bigtreetech/MMB/Hardware/V2.0/BIGTREETECH MMB CAN V2.0-PIN.png

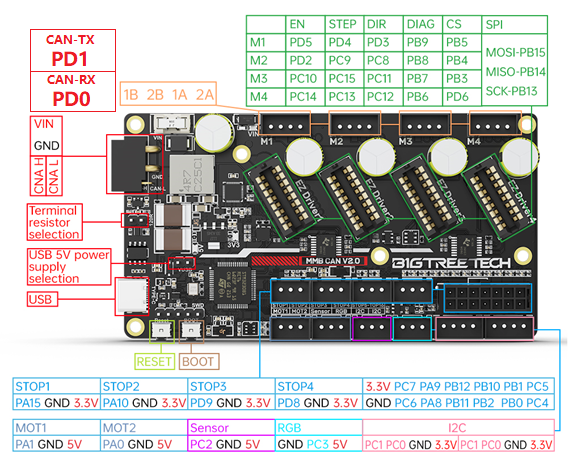
Hardware/V2.0/BIGTREETECH MMB CAN V2.0-PIN.png
