bigtreetech/MMB/3D/[a]_Support_Arm_Endcap_With_MMB_V2_For_ERCT_Buffer.stl

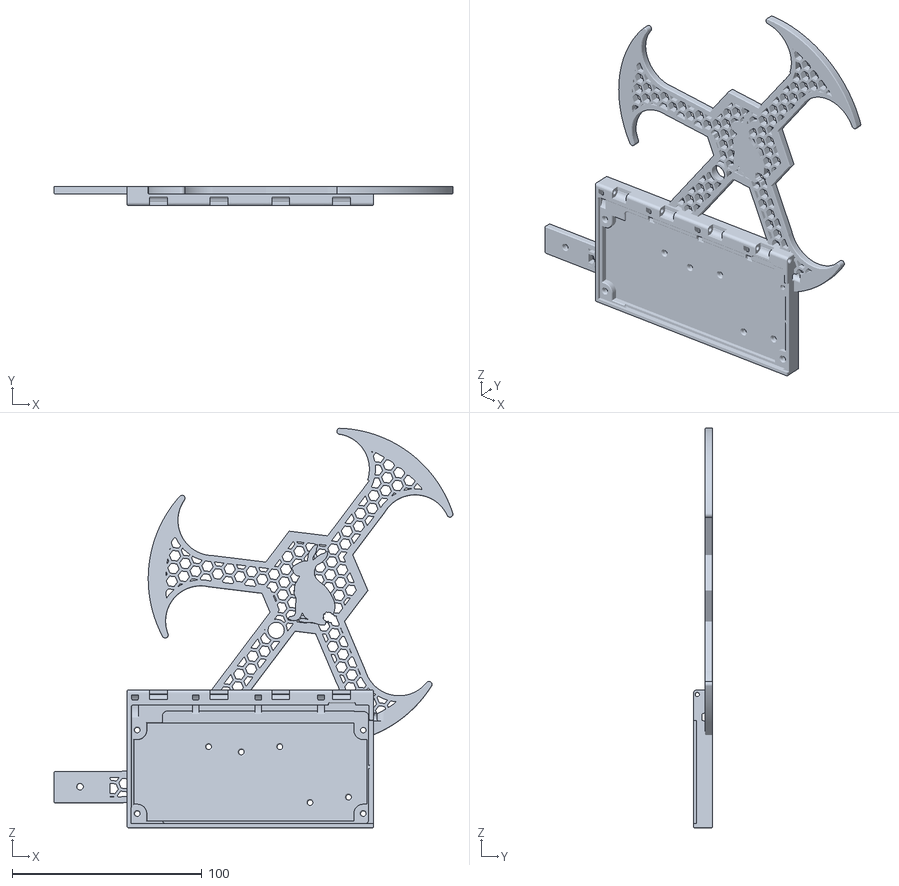
[picture p11: CAD file, 2025-04-17]
3D/[a]_Support_Arm_Endcap_With_MMB_V2_For_ERCT_Buffer.stl
210.1 x 10.1 x 210.4
