bigtreetech/MMB/(threads)

Thread 1 (2023-09-26):

Sensorless not working over Canbus and USB

thiagolocatelli, 2023-09-26:
Trying to run sensorless and keep getting this error:

```
Traceback (most recent call last):
  File "/home/pi/klipper/klippy/mcu.py", line 74, in _do_send
    return xh.get_response(cmds, self._cmd_queue, minclock, reqclock)
  File "/home/pi/klipper/klippy/mcu.py", line 50, in get_response
    raise serialhdl.error("Timeout on wait for '%s' response"
serialhdl.error: Timeout on wait for 'tmcuart_response' response

During handling of the above exception, another exception occurred:

Traceback (most recent call last):
  File "/home/pi/klipper/klippy/extras/homing.py", line 235, in manual_home
    hmove.homing_move(pos, speed, triggered=triggered,
  File "/home/pi/klipper/klippy/extras/homing.py", line 71, in homing_move
    self.printer.send_event("homing:homing_move_begin", self)
  File "/home/pi/klipper/klippy/klippy.py", line 263, in send_event
    return [cb(*params) for cb in self.event_handlers.get(event, [])]
  File "/home/pi/klipper/klippy/klippy.py", line 263, in <listcomp>
    return [cb(*params) for cb in self.event_handlers.get(event, [])]
  File "/home/pi/klipper/klippy/extras/tmc.py", line 524, in handle_homing_move_begin
    self.mcu_tmc.set_register("TCOOLTHRS", tc_val)
  File "/home/pi/klipper/klippy/extras/tmc_uart.py", line 249, in set_register
    self.ifcnt = self._do_get_register("IFCNT")
  File "/home/pi/klipper/klippy/extras/tmc_uart.py", line 230, in _do_get_register
    val = self.mcu_uart.reg_read(self.instance_id, self.addr, reg)
  File "/home/pi/klipper/klippy/extras/tmc_uart.py", line 177, in reg_read
    params = self.tmcuart_send_cmd.send([self.oid, msg, 10])
  File "/home/pi/klipper/klippy/mcu.py", line 78, in send
    return self._do_send([self._cmd.encode(data)], minclock, reqclock)
  File "/home/pi/klipper/klippy/mcu.py", line 76, in _do_send
    raise self._error(str(e))
gcode.CommandError: Timeout on wait for 'tmcuart_response' response
```

Configuration

```
[duplicate_pin_override]
pins: kms_mcu_1:PB2,kms_mcu_1:PC15

[tmc2209 manual_extruder_stepper kms_mmu_feeder_T0]
uart_pin: kms_mcu_1:PA10
interpolate: True
run_current: 0.90
#hold_current: 0.1
sense_resistor: 0.110
#stealthchop_threshold: 999999
diag_pin: ^kms_mcu_1:PA3
driver_SGTHRS: 75

[manual_extruder_stepper kms_mmu_feeder_T0]
step_pin: kms_mcu_1:PB15
dir_pin: !kms_mcu_1:PB14
enable_pin: !kms_mcu_1:PA8
rotation_distance: 22.6789511
microsteps: 16
full_steps_per_rotation: 200 #200 for 1.8 degree, 400 for 0.9 degree
velocity: 35
accel: 150
endstop_pin: tmc2209_kms_mmu_feeder_T0:virtual_endstop
endstop_name: kms_sensorless_endstop_1
# Uncomment two lines below to give option of  selector "touch" movement and homing
#extra_endstop_pins: tmc2209_kms_mmu_feeder_T0:virtual_endstop,kms_mcu_1:PB2
#extra_endstop_names: kms_virtual_endstop_T0,kms_splitter_endstop_1
```

Collapsednut, 2023-10-06:
Just a random thought cause I'm also going to be using sensorless on this board. I assume you have a jumper on the diag pins for driver 1 and I see that is linked to the PA3 pin of stop-1 on the schematic. Maybe try manually with a jumper wire going to a different stop pin like PA4 or PB8 and define in config. Maybe just maybe the trace on the board connecting diag1 to PA3 is faulty is what I'm getting at.

thiagolocatelli, 2023-10-06:
@Collapsednut I have tried all that and also checked for continuity between all diag pins

ntchris, 2023-11-10:
for ERCF / happy hare v23 ... I think sensorless is for gate selector , not for extruder ?

Also , hope this can help a little bit maybe
https://github.com/ntchris/voron_mod_super_diy/tree/main/for_enraged_rabbit/btt_ERCF_Canbus

Thread 4 (2023-10-14):

Katapult "make flash" does not exist. STM32 programmer fails

Collapsednut, 2023-10-14:
Katapult does not support the make flash command.
Attempting to use STM32CubeProgrammer results in errors and unable to flash.
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

Collapsednut, 2023-10-14:
I was able to flash by using this:
dfu-util -a 0 -D ~/katapult/out/katapult.bin -s 0x08000000:mass-erase:force:leave

ntchris, 2023-11-10:
right, make flash doesn't work.

try this when you have a chance, good luck
https://github.com/ntchris/voron_mod_super_diy/tree/main/for_enraged_rabbit/btt_ERCF_Canbus

Thread 5 (2023-11-27):

Documentation needs to be improved around function of CAN vs. USB vs. HVIN

kieraneglin, 2023-11-27:
It is very unclear that you MUST use the CAN connector to power the board and cannot use the HVIN + USB connectors alone.

For future readers, here's how the various connectors work for real-world usage:

- If you're flashing firmware, you can connect just USB with the `VUSB` jumper in place. >>> _Be certain to remove the `VUSB` jumper before connecting any power or CAN cables_ <<<
- If using CAN as a communication interface and you don't need extra juice for the steppers, just connect the CAN plug
   - Set each stepper voltage jumper to `VIN`
   - If your mainboard supports CAN but you otherwise don't know what to do, this is probably the option you want
- If using CAN as a communication interface and you DO need extra power for the steppers, connect the CAN plug and also connect your additional power leads to the `HVIN` and `GND`
   - Set each stepper voltage jumper to `HVIN`
-  If using USB as a communication interface and you don't need extra juice for the steppers, you have to connect the CAN plug and put 12-24v through its power leads. You then have to connect a USB cable from your printer to the MMB
  - Set each stepper voltage jumper to `VIN`
    - If your mainboard DOES NOT support CAN but you otherwise don't know what to do, this is probably the option you want
-  If using USB as a communication interface and you DO need extra power for the steppers, you have to connect the CAN plug and put 12-24v through its power leads and also connect your additional power leads to the `HVIN` and `GND`. You then have to connect a USB cable from your printer to the MMB
   - Set each stepper voltage jumper to `HVIN`

tmshader, 2024-07-24:
Why can't HVIN work with the VUSB jumper? I tried it with the v1.1 board and it works flawlessly. I have my stepper jumpers on HVIN and I power the rest of the board with the USB cable and I haven't had any problems yet.

AustinTylerDean, 2024-08-12:
> Why can't HVIN work with the VUSB jumper? I tried it with the v1.1 board and it works flawlessly. I have my stepper jumpers on HVIN and I power the rest of the board with the USB cable and I haven't had any problems yet.

I really hope this is correct, and that BTT comes back and says "Yes, do this."

It's terribly confusing when you connect the HVIN 24V and GND, pull the jumper, connect USB, and turn the thing on only to not see anything light up! Thanks to OP for the info as well!

AustinTylerDean, 2024-08-12:
> Why can't HVIN work with the VUSB jumper? I tried it with the v1.1 board and it works flawlessly. I have my stepper jumpers on HVIN and I power the rest of the board with the USB cable and I haven't had any problems yet.

I am not an electrical engineer, but I did take a stab at the schematic. I can't tell if the servo is getting power from the USB or the HVIN. I started getting confused. My worry is that these servos are expecting 4.8-6v. I don't know if VUSB is getting bumped to that or not. Would love some confirmation. I have sent an email to BTT. We will see what that brings.

tmshader, 2024-10-15:
So I had time to review the schematics and as far as I can tell, the USB connects without any voltage conversion to the same +5V rail that the DC_IN of the CANBUS connector connects to, but the CANBUS is stepped down to 5V, so they are both used for powering the servo. The HVIN is only connected to the motor drivers and only if those specific jumpers are selected. So it should be safe to use CANBUS to power and USB to communicate, but you **HAVE** to power the board through CANBUS because the USB connection cannot provide enough amps to drive the servo. And you can use HVIN with a secondary power supply to give power to the motors, if your CANBUS can't provide enough amps to drive the motors and the servo simultaneously.

pahofmann, 2025-04-30:
Glad I found this, sad it hasn't made it to the manual after years...

Thread 7 (2023-12-02):

Wrong Pins

oMTEo, 2023-12-02:
Im on build a ERCF with your MMB-Board and found 2 wrong declared pins, Ive fixed it in the following pic (red arrows)

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

Xonman, 2024-01-12:
@Motalw hopefully you have got it working by now, but the manual incorrectly shows ABAB. Steppers should be wired AABB to work correctly.

colindembovsky, 2024-04-07:
@Xonman @Motalw I had the same issue and wiring AABB worked for me.

kullwarrior, 2024-05-10:
V1.1 Pins slightly changed.
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

mrellifant, 2024-05-18:
Hi @kullwarrior - is that diagram correct for the v1.1? the stepper 1A 1B 2A 2B doesn't match the manual which was also updated for v1.1 last week (about the same time as your post) its 1B 2B 1A 1B - and this is the same as the ERCF v2 manual.
I'm having troubles getting NEMA17 steppers to work properly using the latter (and also finding the proper pinouts for the trianglelabs TL-42BYGH20 which they're suppling in their ercf v2 kit).
thanks Wayne.

dbookusa1, 2024-06-15:
That is the difference between a v1.1 and the V1.0.

Thread 8 (2023-12-30):

document diag pin usage for stallguard

lesaux, 2023-12-30:
please give clear instructions on using stallguard on this board.
The diag pins seems to be shared, PA3, PA4 but when I jumper diag pins, PA3 PA4 are still working as endstops so this is confusing.
could you please share working configs for stallguard of both UART and SPI steppers.

The following is what I thought should work with Happy-Hare but it doesn't - The limit switch works but stallguard doesn't (or it ignores SGT setting) :
```
[tmc5160 stepper_mmu_selector]
cs_pin: mmuv2:PC7 #motor2
spi_bus: spi1
run_current: 0.4
hold_current: 0.2
interpolate: True
sense_resistor: 0.075
stealthchop_threshold: 100
diag1_pin: ^!mmuv2:PA4            #motor2 diag pin - also an endstop with nothing plugged into it.
driver_SGT: 3 # -64 -> 64

[stepper_mmu_selector]
step_pin: mmuv2:PD2
dir_pin: !mmuv2:PB13
enable_pin: !mmuv2:PD1
rotation_distance: 40
microsteps: 16                               # Don't need high fidelity
full_steps_per_rotation: 200        # 200 for 1.8 degree, 400 for 0.9 degree
endstop_pin: ^mmuv2:PB2.         # Selector microswitch
endstop_name: mmu_sel_home
#
# Uncomment two lines below to give option of  selector "touch" movement and homing
extra_endstop_pins: tmc5160_stepper_mmu_selector:virtual_endstop
extra_endstop_names: mmu_sel_touch
```

if the limit switch is unplugged, stallguard works, and if its plugged, it doesn't.

Any insights would be appreciated.

lesaux, 2024-02-04:
Sorry this was the expected happy hare behaviour.

Closed 2024-02-04.

Thread 11 (2024-06-02):

CAN bus wiring with EBB SB2209, U2C, and MMB

ksteddom, 2024-06-02:
What is the preferred way to wire the CAN bus when you have multiple devices? In my example I have the SB2209 tool head board connected to my pi via a U2C adapter. What order should the three devices be in the bus and which ones get the 120R resistor jumpers?

alidaf, 2024-06-24:
120R jumpers go on the start and end points of the CanBUS so on your U2C adapter and SB2209 toolhead board. Your Pi isn't part of the CanBUS - it's just communicating over USB with the U2C, which implements CanBUS.

alidaf, 2024-06-24:
I think in your case all signals originate from the U2C so it is the start. If you have 2 cables from the U2C, 1 to the the MMB and 1 to the toolhead then you have a star network, the peripherals are still end devices and both need jumpers along with the U2C. If you have 1 cable from the U2C to the toolhead, and then 1 from the toolhead to the MMB then these would be daisy-chained so only the U2C and MMB need jumpers (the toolhead is in the middle). I've never seen this config in practice as the toolhead would need another CanBUS socket and I've not seen any like this.

Thread 13 (2024-12-12):

Connector PA8 not working von BTT MMB CAN V1.1

mandaponk, 2024-12-12:
Hello everyone,

I'm not sure if this is the right place, but I'll ask my question anyway.

I have built an ERCF v2 and everything is working perfectly.

The only issue is that one of the 8 pre_gate_sensors is not working.
I have checked the switch, the cable, and the board.
The other sensors work flawlessly, no matter which port they are connected to.
As soon as the sensors are connected to PA8, they stop working. Once I reconnect them to their original ports, they work again.

I'm not sure how to rule out a software or hardware error at this point.

Maybe someone can help me.

Best regards and thank you.

Thread 14 (2024-12-25):

MMB v2 data missing

BlackNet, 2024-12-25:
*ALL* Github data is missing for the MMB V2 board.  Please add that ASAP

bigtreetech, 2024-12-25:
What MMB V2 board?

BlackNet, 2024-12-25:
The second version of the MMB board is now shipping.

bigtreetech, 2024-12-25:
Nope, there is no official second version and most certainly nothing shipping.

BlackNet, 2024-12-25:
Please explain this then.

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

bigtreetech, 2024-12-25:
Are you a part of a beta program?

BlackNet, 2024-12-25:
No, I am not. It was received via regular channels on an open purchase.

Closed 2024-12-25.

Thread 15 (2024-12-30):

BTT MMU wrong pin

chadakenn, 2024-12-30:
MMU_GEAR_ENABLE=PA8 should be PB8 for v1.1

Thread 16 (2025-01-27):

MMB v2 missing files

BlackNet, 2025-01-27:
MMB v2 is missing the hardware layout/ pinouts and step file.

looxonline, 2025-01-27:
At the moment the pins information is contained within the user manual. The STEP file will be added after the Spring festival ends. @BTTJUSTIN

BlackNet, 2025-01-30:
Have no clue what you are on about with spring. Spring of which year?

Why so long and what's the delay about?

randybb, 2025-01-30:
Because no one works during Chinese New Year (= Spring Festival).

Manu512, 2025-02-16:
Missing files and Wrong parameters.
2 days lost because documentation say PD0 and PD1 for can.
With PB0 and PB1 all works.

BlackNet, 2025-02-16:
What we ended up doing was take an ohm meter and probe the chip and found the right pin. 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

BlackNet, 2025-02-24:
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

I can confirm I have a functional MMB2 board using CAN, and it does indeed use the pinout photo I listed earlier on PD1.

`
CONFIG_STM32_MMENU_CANBUS_PD0_PD1=y
CONFIG_STM32_CANBUS_PD0_PD1=y
`

I do not have listings for stp5-16.

bigtreetech, 2025-02-25:
> Missing files and Wrong parameters. 2 days lost because documentation say PD0 and PD1 for can. With PB0 and PB1 all works.

Version 2 is most certainly PD1 and PD0. There is no possible way that PB would work for CAN. All of the required information is in the manual. STEP files have been uploaded now.

m3cinc, 2025-02-28:
Can you please post the stop pin layout in more details. It is not very precise to just mention stp5-16 without a pin diagram.
Thanks in advance.

looxonline, 2025-02-28:
All of the pins for stop pins have their pin numbers labeled on the existing pin diagram.

m3cinc, 2025-02-28:
There are 2 rows of pins indeed labeled PC7, PA9, etc...
My question is which stop pin do they represent? a corresponding table between stop # and pin # is needed.
Thanks in advance.

looxonline, 2025-02-28:
Does it matter though? Ultimately it is just a stop pin and you can call each one whatever you want in the firmware. You assign it a function in the cfg file.

m3cinc, 2025-02-28:
Agree, but when you configure and build multiple units, you like to have
all the specifications identical... I am using klippain to program and
would hate to have multiple configurations for these units.

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

Closed 2025-02-25.

Thread 18 (2025-01-31):

MMB SPI conection

destruct123, 2025-01-31:
I'm using MANTA E3 EZ + MMB V1, having TMC SPI conection issue. Global scaler everytime i try to move the motor

Thread 19 (2025-02-22):

Flash Firmware through USB ends im [src/stm32/Makefile:111: flash] Error 255

LordMM74, 2025-02-22:
I tried do flash firmware through usb like described in docs.

pi@RatOS:~ $ lsusb
Bus 002 Device 001: ID 1d6b:0003 Linux Foundation 3.0 root hub
Bus 001 Device 003: ID 0483:df11 STMicroelectronics STM Device in DFU Mode
Bus 001 Device 002: ID 2109:3431 VIA Labs, Inc. Hub
Bus 001 Device 001: ID 1d6b:0002 Linux Foundation 2.0 root hub

pi@RatOS:~/klipper $ make flash FLASH_DEVICE=0483:df11
  Flashing out/klipper.bin to 0483:df11
sudo dfu-util -d ,0483:df11 -R -a 0 -s 0x8000000:leave -D out/klipper.bin

[sudo] password for pi:
dfu-util 0.11-dev

Copyright 2005-2009 Weston Schmidt, Harald Welte and OpenMoko Inc.
Copyright 2010-2021 Tormod Volden and Stefan Schmidt
This program is Free Software and has ABSOLUTELY NO WARRANTY
Please report bugs to http://sourceforge.net/p/dfu-util/tickets/

dfu-util: Warning: Invalid DFU suffix signature
dfu-util: A valid DFU suffix will be required in a future dfu-util release
Opening DFU capable USB device...
Device ID 0483:df11
Device DFU version 011a
Claiming USB DFU Interface...
Setting Alternate Interface #0 ...
Determining device status...
DFU state(2) = dfuIDLE, status(0) = No error condition is present
DFU mode device DFU version 011a
Device returned transfer size 1024
DfuSe interface name: "Internal Flash   "
Downloading element to address = 0x08000000, size = 30928
Erase           [=========================] 100%        30928 bytes
Erase    done.
Download        [=========================] 100%        30928 bytes
Download done.
File downloaded successfully
Submitting leave request...
dfu-util: Error during download get_status: -9 (LIBUSB_ERROR_PIPE)

Failed to flash to 0483:df11: Error running dfu-util

If the device is already in bootloader mode it can be flashed with the
following command:
  make flash FLASH_DEVICE=0483:df11
  OR
  make flash FLASH_DEVICE=1209:beba

If attempting to flash via 3.3V serial, then use:
  make serialflash FLASH_DEVICE=0483:df11

make: *** [src/stm32/Makefile:111: flash] Error 255

I retried step by step the docs several times.

The BTT MMB CAN is connected through usb to raspberry pi.
The VUSB jumper is set to power the board through usb.
Botting into DFU mode seems to work ... lsusb shows the board.

8bit-boom, 2025-03-06:
I have same problem, did you find solution to it?

bigtreetech, 2025-03-07:
Ignore this error if it happens. What matters is that the firmward download reaches 100%

Closed 2025-02-22.

Thread 20 (2025-03-14):

Faulty driver M2 => Selector

Muttley65, 2025-03-14:
Hi guys , i'm struggling with ECRF V2 MMU . I have faulty driver M2 that makes the selector work , i want to check if the MMU can be used or fall in the recycle bin .

Since that it has 4 driver for motor how i can set mmu.cfg alias associations ?

I can choose any driver or there is some rules to follow ?

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

Many thanks for help

3DCoded, 2025-04-08:
@Muttley65 ,

You can use any stepper driver.

To use M3 for the selector:

```
MMU_SEL_UART=PB3
MMU_SEL_STEP=PC15
MMU_SEL_DIR=PC11
MMU_SEL_ENABLE=PC10
MMU_SEL_DIAG=PB7
```
