bigtreetech/MMB/Hardware/V2.0/BIGTREETECH MMB CAN V2.0-SCH.pdf

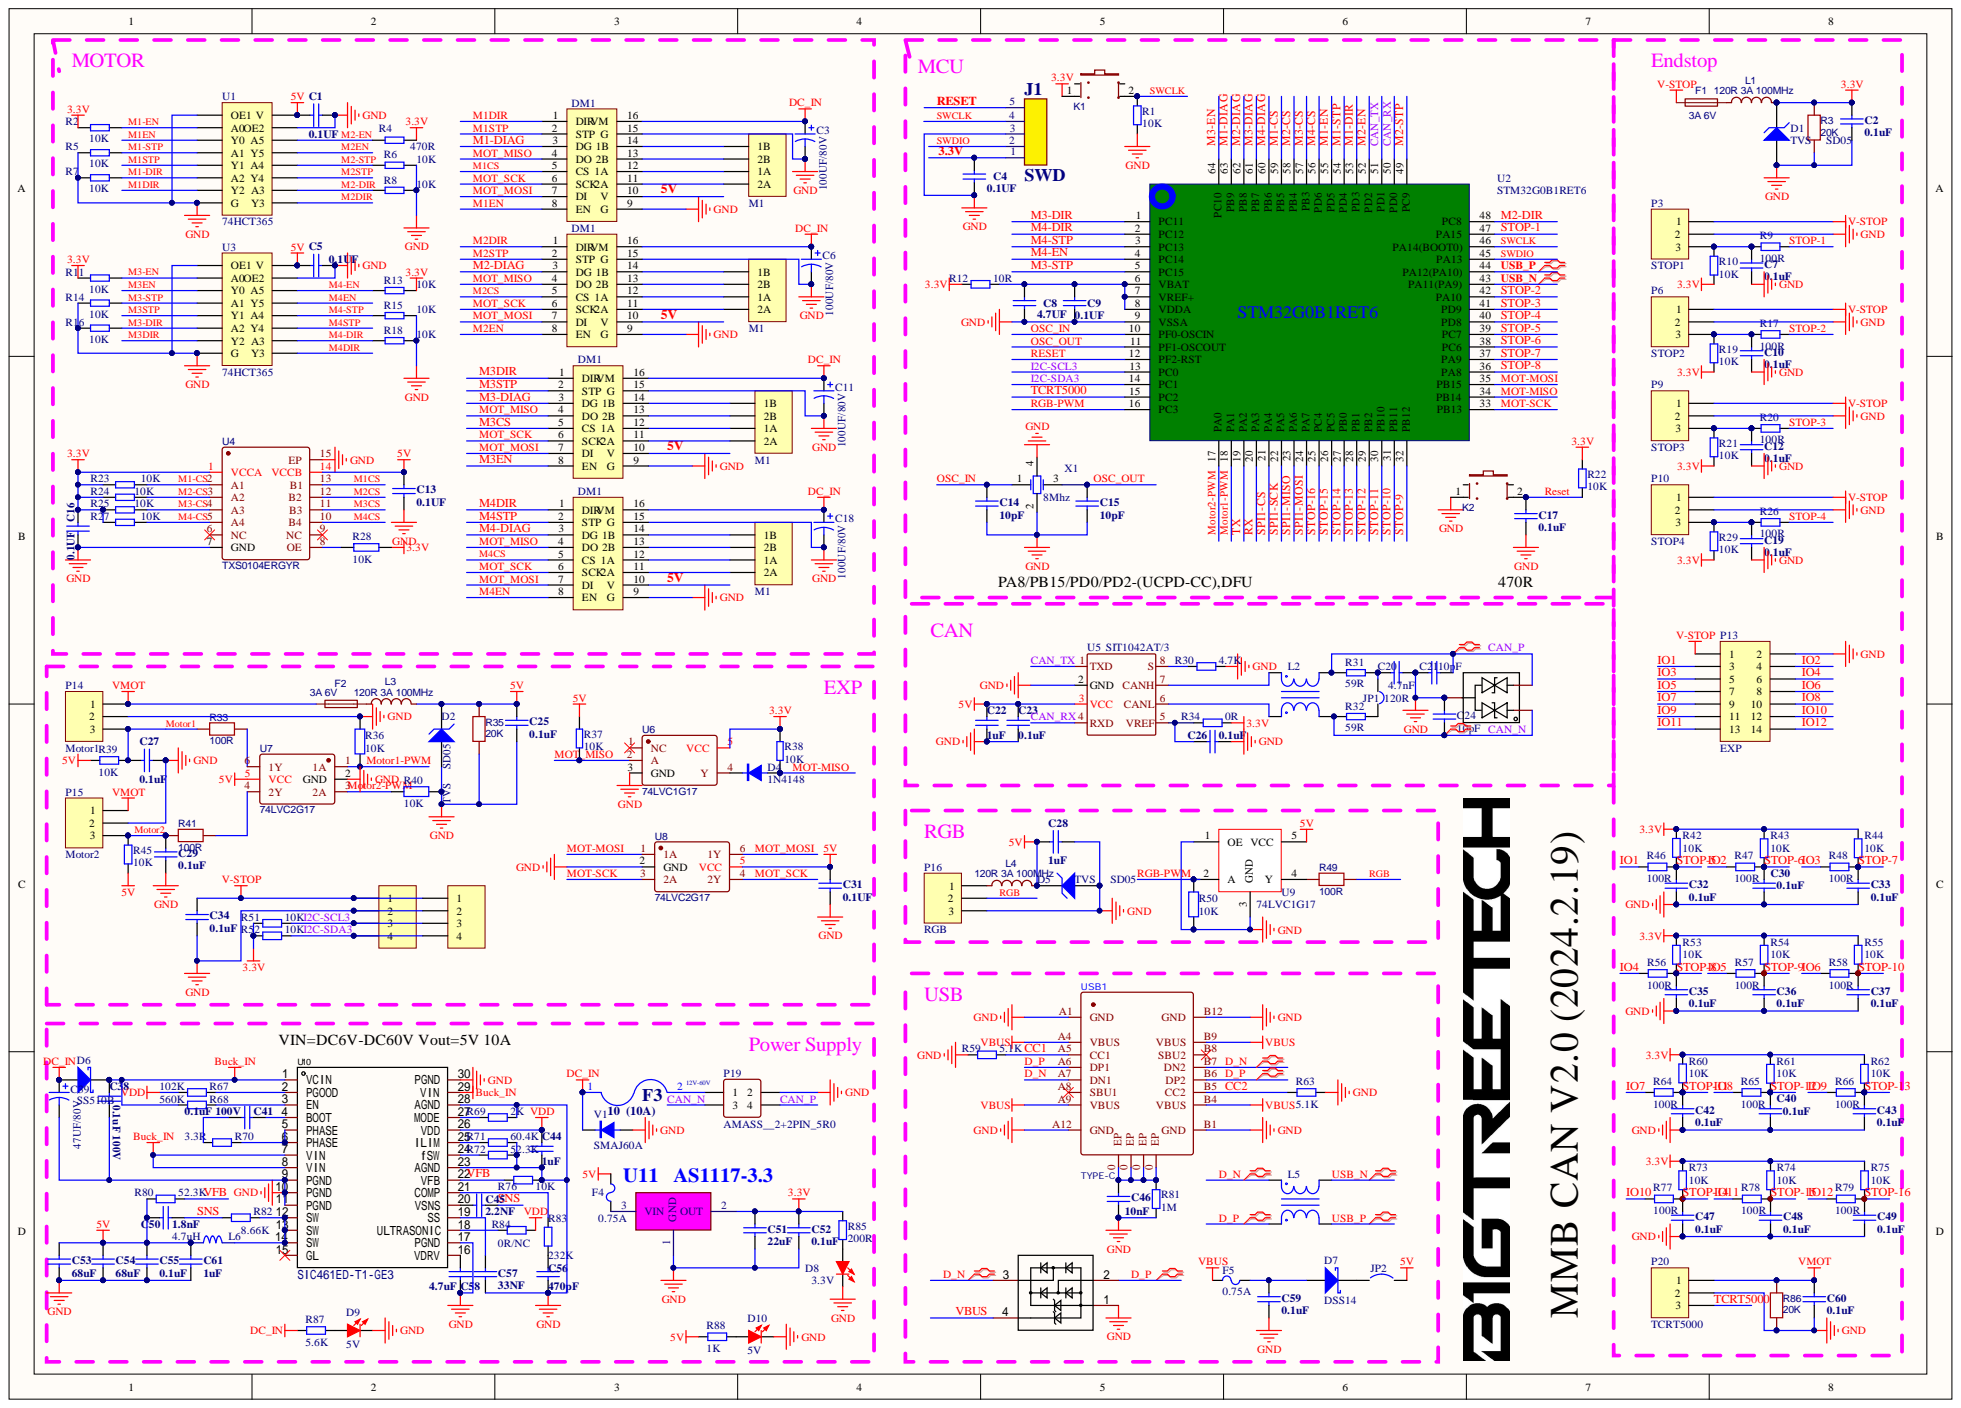
[picture p13: page 1]

I2C-SCL3

VFB
