bigtreetech/MMB/Hardware/V2.0/BIGTREETECH MMB CAN V2.0-SIZE.pdf

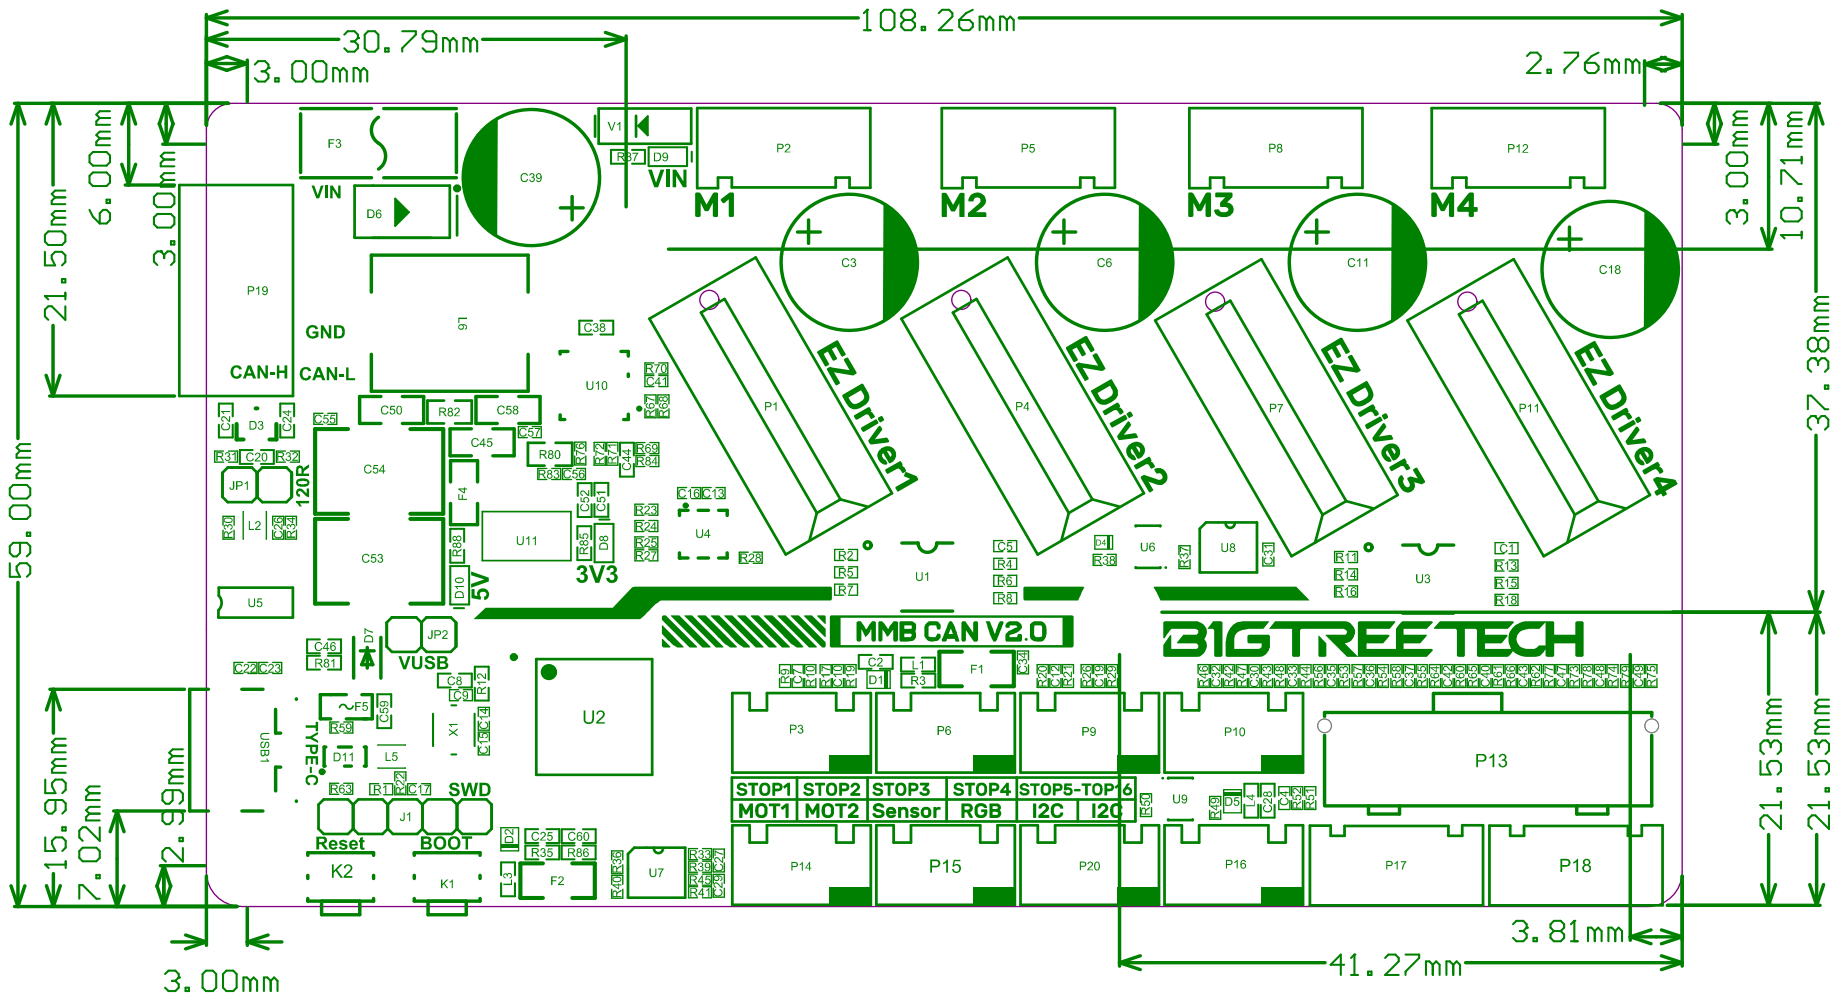
[picture p14: page 1]
