bigtreetech/MMB/Hardware/V1.0/BIGTREETECH MMB CAN V1.0-SCH.pdf

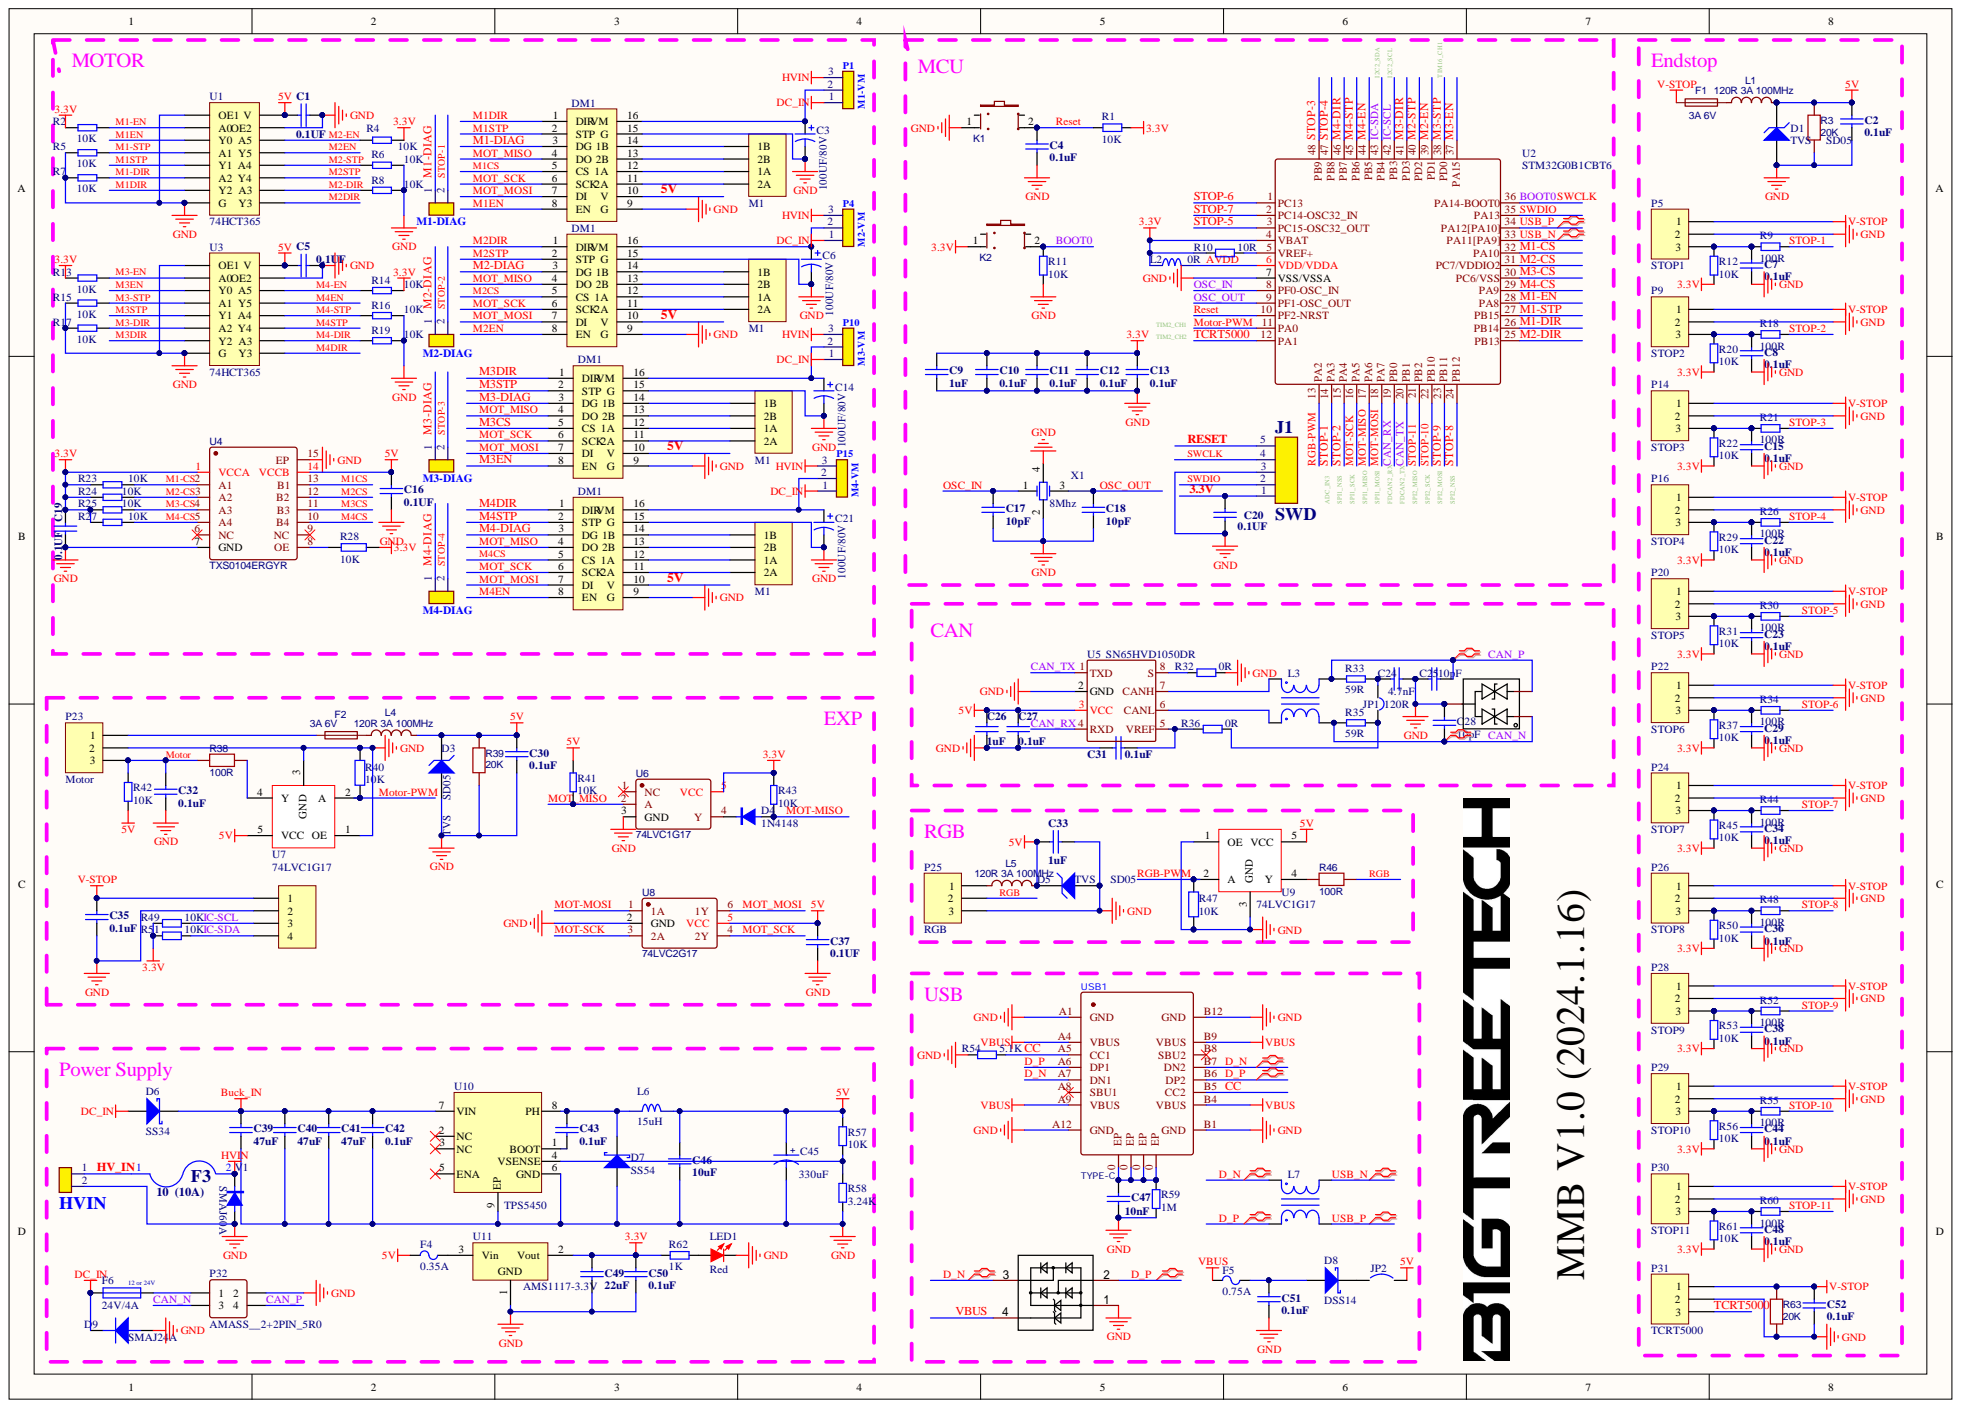
[picture p15: page 1]

M1EN | STOP-7 PC14-OSC32_IN 2
