bigtreetech/MMB/Hardware/V1.0/BIGTREETECH MMB CAN V1.0-SIZE.pdf

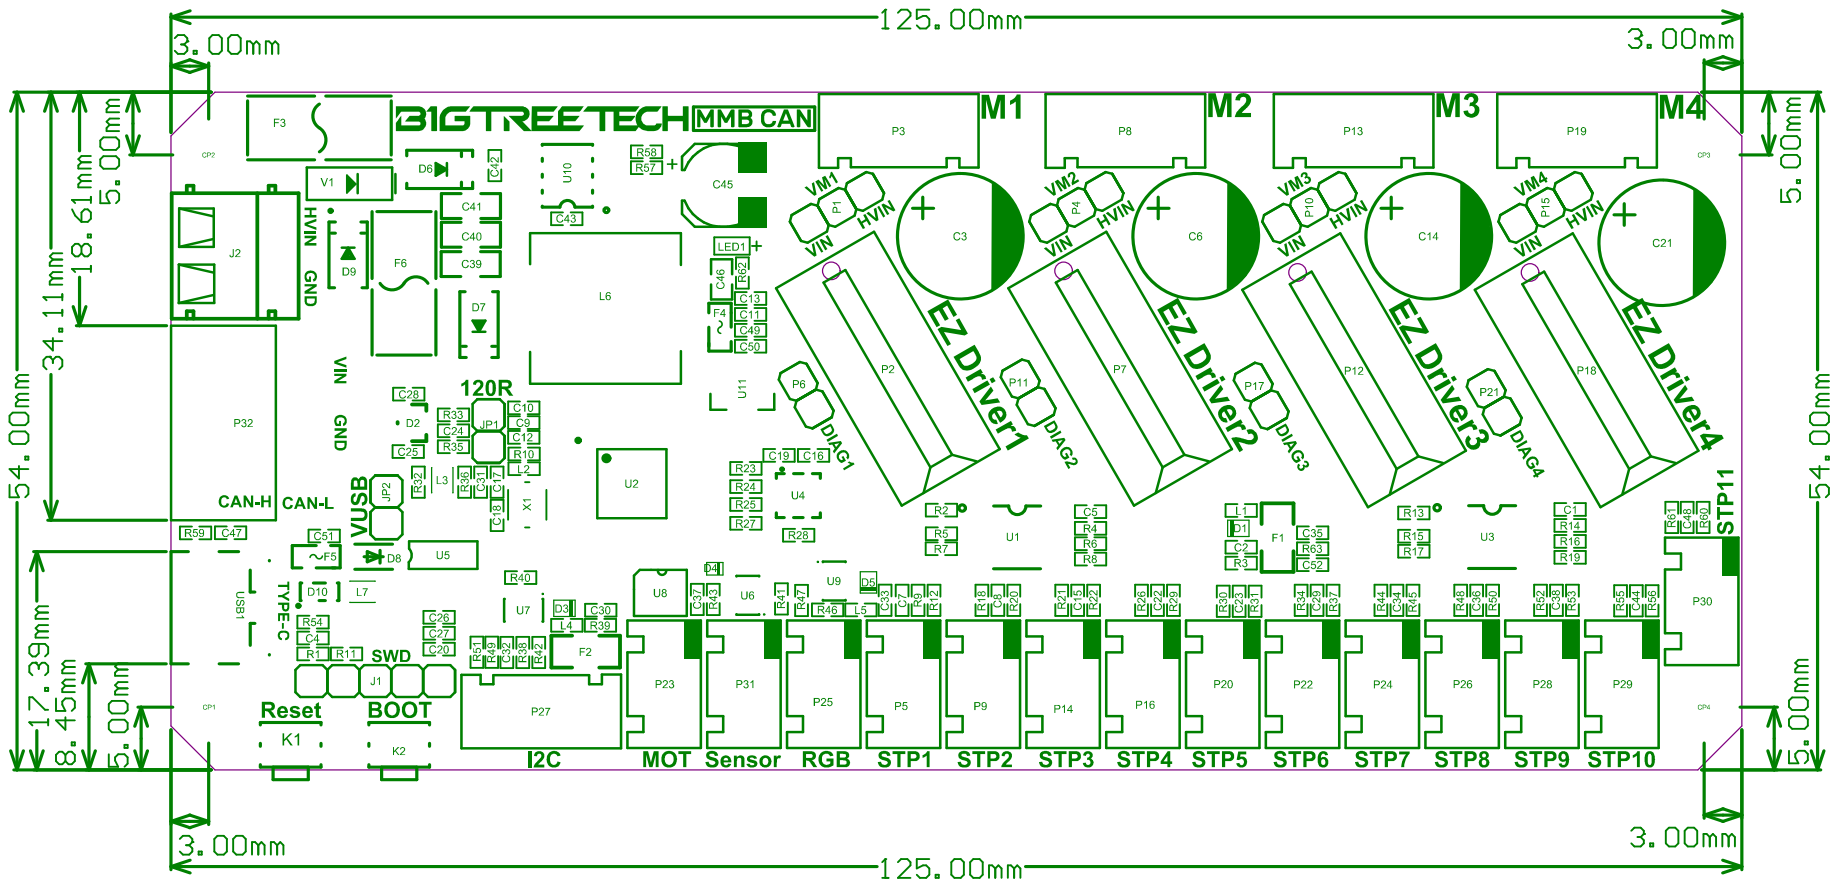
[picture p16: page 1]
