bigtreetech/MMB/(commit log)

2023-08-25 init MMB
    [bigtreetech-mmb-ercf.cfg, sample-bigtreetech-mmb-canbus.cfg]
2024-01-17 update manual
    [bigtreetech-mmb-ercf.cfg]
2024-05-11 add v1.1
    [bigtreetech-mmb-ercf.cfg, sample-bigtreetech-mmb-canbus.cfg]
2025-01-16 mmb v2.0
    [sample-bigtreetech-mmb-canbus-v1.x.cfg, sample-bigtreetech-mmb-canbus-v2.0.cfg]
2025-04-17 add stl for MMB from https://www.printables.com/model/1197828-ercfv2-support-arm-endcap-with-btt-mmb-v20-for-erc/files
    [[a]_Support_Arm_Endcap_With_MMB_V2_For_ERCT_Buffer.stl]
